tom-got-it/wall-e/images/ota-1.png

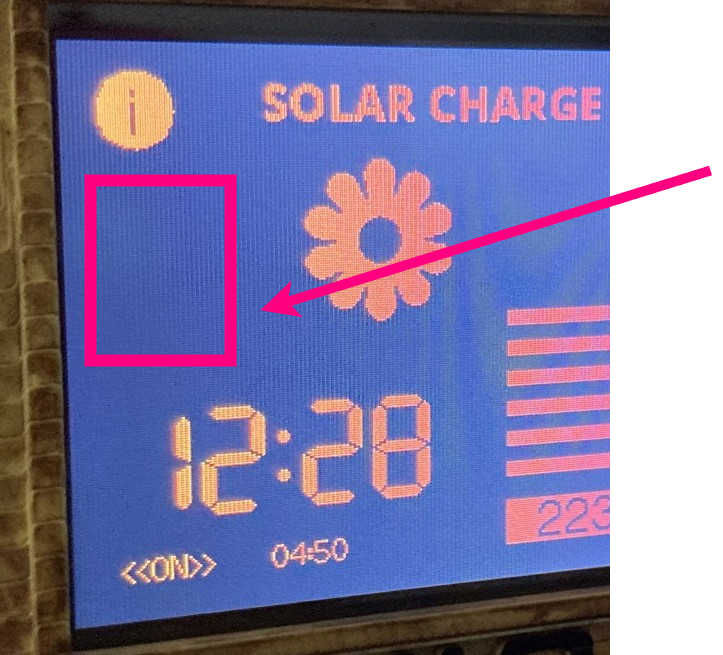
images/ota-1.png
