tom-got-it/wall-e/images/robot-7-front.jpg

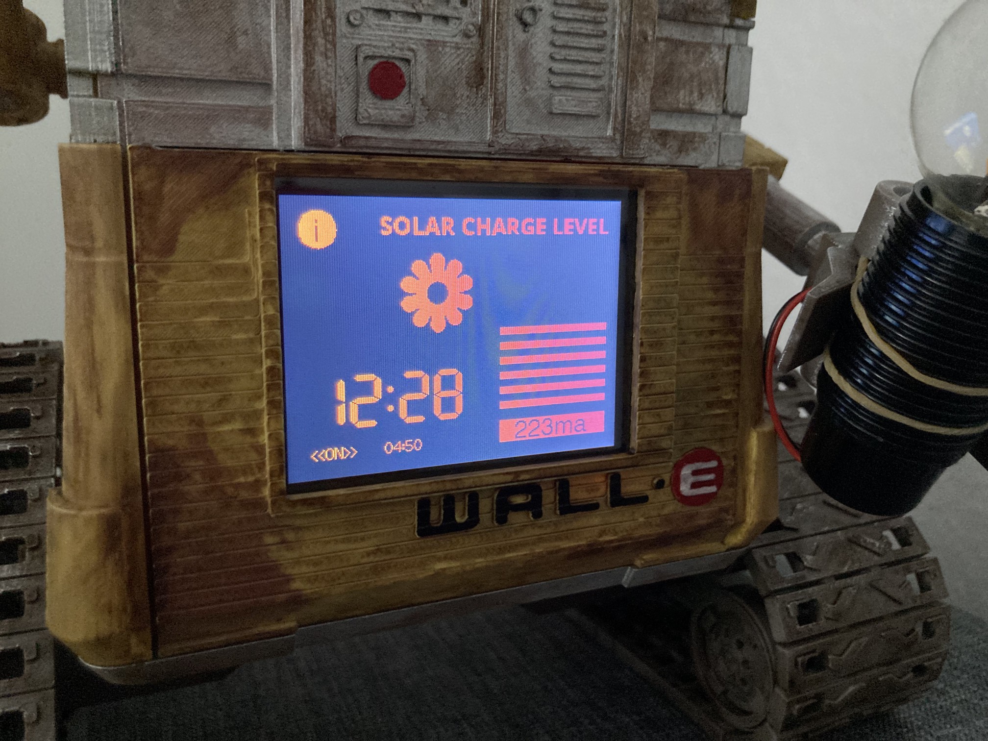
images/robot-7-front.jpg
