tom-got-it/wall-e/(threads)

Thread 1 (2024-08-18):

Flashing light and strange operation of 18650

CarbonVDA, 2024-08-18:
Hello! I have already completely assembled your Wall-E. But, unfortunately, two problems arose. I would really appreciate any help in solving them.
1. The light bulb (5v) starts blinking after a few seconds and the blinking intensifies, and after 30 seconds it turns off.
2. 18650 powers the system, but it’s not at all clear how everything works. The screen always shows 1 division, writes USB and 0.0v or -001.
Thanks in advance for any help.

tom-got-it, 2024-08-18:
Hey CarbonVDA. I hope that I can help - will try my best.

The shutdown after 30 seconds is normal. It is a safety feature to prevent the battery from draining as the light bulb draws a lot of power. The time to auto-shutoff can be configured in file include/global.h.

The blinking however is not normal. I suggest to check the lightbulb and the relay. If possible try to connect the light bulb directly to a 3 to 5v power source directly for testing.

If you power the system by battery and USB power is shown on screen, most certainly there is something wrong with the power sensor (the INA 260 module). The system will try to connect to the INA260 at boot-time. If this fails, it will assume that it is powered by USB. If you built the system without this module it should work nevertheless, but print out USB always. The same module is also used to estimate the charge level of the battery by measuring the battery voltage.

CarbonVDA, 2024-08-19:
Thanks, friend! I connected the light bulb directly from 18650 - there is no flickering. Instead of a light bulb, I connected a voltmeter to the relay, it produces exactly 5 volts. It’s strange why the light from the relay starts flickering after a few seconds. I'll order another INA260, maybe I overheated it when soldering.

Thread 3 (2025-02-23):

Numerous errors. SPIFFS not declared

3dprintandpaint, 2025-02-23:
Hi, I have followed the instructions provided, but cannot progress due to ongoing issues when trying to upload the provided code.

I get a combination of errors as follows:

In file included from C:\Users\monke\AppData\Local\Arduino15\packages\esp32\hardware\esp32\3.1.1\libraries\WebServer\src/HTTP_Method.h:4,
                 from C:\Users\monke\AppData\Local\Arduino15\packages\esp32\hardware\esp32\3.1.1\libraries\WebServer\src/WebServer.h:30,
                 from C:\Users\monke\Documents\Arduino\libraries\ElegantOTA\src/ElegantOTA.h:66,
                 from C:\Users\monke\Downloads\wall-e-main\wall-e-main\src\wall-e\include\global.h:12,
                 from C:\Users\monke\Downloads\wall-e-main\wall-e-main\src\wall-e\wall-e.ino:1:
C:\Users\monke\AppData\Local\Arduino15\packages\esp32\tools\esp32-arduino-libs\idf-release_v5.3-cfea4f7c-v1\esp32/include/http_parser/http_parser.h:95:6: error: 'HTTP_DELETE' conflicts with a previous declaration
   95 |   XX(0,  DELETE,      DELETE)       \
      |      ^
C:\Users\monke\AppData\Local\Arduino15\packages\esp32\tools\esp32-arduino-libs\idf-release_v5.3-cfea4f7c-v1\esp32/include/http_parser/http_parser.h:138:45: note: in definition of macro 'XX'
  138 | #define XX(num, name, string) HTTP_##name = num,
      |                                             ^~~
C:\Users\monke\AppData\Local\Arduino15\packages\esp32\tools\esp32-arduino-libs\idf-release_v5.3-cfea4f7c-v1\esp32/include/http_parser/http_parser.h:139:3: note: in expansion of macro 'HTTP_METHOD_MAP'
  139 |   HTTP_METHOD_MAP(XX)
      |   ^~~~~~~~~~~~~~~
In file included from C:\Users\monke\Downloads\wall-e-main\wall-e-main\src\wall-e\include\global.h:11:
C:\Users\monke\Documents\Arduino\libraries\ESPAsyncWebServer\src/ESPAsyncWebServer.h:64:3: note: previous declaration 'WebRequestMethod HTTP_DELETE'
   64 |   HTTP_DELETE  = 0b00000100,
      |   ^~~~~~~~~~~
C:\Users\monke\AppData\Local\Arduino15\packages\esp32\tools\esp32-arduino-libs\idf-release_v5.3-cfea4f7c-v1\esp32/include/http_parser/http_parser.h:96:6: error: 'HTTP_GET' conflicts with a previous declaration
   96 |   XX(1,  GET,         GET)          \
      |      ^
C:\Users\monke\AppData\Local\Arduino15\packages\esp32\tools\esp32-arduino-libs\idf-release_v5.3-cfea4f7c-v1\esp32/include/http_parser/http_parser.h:138:45: note: in definition of macro 'XX'
  138 | #define XX(num, name, string) HTTP_##name = num,
      |                                             ^~~
C:\Users\monke\AppData\Local\Arduino15\packages\esp32\tools\esp32-arduino-libs\idf-release_v5.3-cfea4f7c-v1\esp32/include/http_parser/http_parser.h:139:3: note: in expansion of macro 'HTTP_METHOD_MAP'
  139 |   HTTP_METHOD_MAP(XX)
      |   ^~~~~~~~~~~~~~~
C:\Users\monke\Documents\Arduino\libraries\ESPAsyncWebServer\src/ESPAsyncWebServer.h:62:3: note: previous declaration 'WebRequestMethod HTTP_GET'
   62 |   HTTP_GET     = 0b00000001,
      |   ^~~~~~~~
C:\Users\monke\AppData\Local\Arduino15\packages\esp32\tools\esp32-arduino-libs\idf-release_v5.3-cfea4f7c-v1\esp32/include/http_parser/http_parser.h:97:6: error: 'HTTP_HEAD' conflicts with a previous declaration
   97 |   XX(2,  HEAD,        HEAD)         \
      |      ^
C:\Users\monke\AppData\Local\Arduino15\packages\esp32\tools\esp32-arduino-libs\idf-release_v5.3-cfea4f7c-v1\esp32/include/http_parser/http_parser.h:138:45: note: in definition of macro 'XX'
  138 | #define XX(num, name, string) HTTP_##name = num,
      |                                             ^~~
C:\Users\monke\AppData\Local\Arduino15\packages\esp32\tools\esp32-arduino-libs\idf-release_v5.3-cfea4f7c-v1\esp32/include/http_parser/http_parser.h:139:3: note: in expansion of macro 'HTTP_METHOD_MAP'
  139 |   HTTP_METHOD_MAP(XX)
      |   ^~~~~~~~~~~~~~~
C:\Users\monke\Documents\Arduino\libraries\ESPAsyncWebServer\src/ESPAsyncWebServer.h:67:3: note: previous declaration 'WebRequestMethod HTTP_HEAD'
   67 |   HTTP_HEAD    = 0b00100000,
      |   ^~~~~~~~~
C:\Users\monke\AppData\Local\Arduino15\packages\esp32\tools\esp32-arduino-libs\idf-release_v5.3-cfea4f7c-v1\esp32/include/http_parser/http_parser.h:98:6: error: 'HTTP_POST' conflicts with a previous declaration
   98 |   XX(3,  POST,        POST)         \
      |      ^
C:\Users\monke\AppData\Local\Arduino15\packages\esp32\tools\esp32-arduino-libs\idf-release_v5.3-cfea4f7c-v1\esp32/include/http_parser/http_parser.h:138:45: note: in definition of macro 'XX'
  138 | #define XX(num, name, string) HTTP_##name = num,
      |                                             ^~~
C:\Users\monke\AppData\Local\Arduino15\packages\esp32\tools\esp32-arduino-libs\idf-release_v5.3-cfea4f7c-v1\esp32/include/http_parser/http_parser.h:139:3: note: in expansion of macro 'HTTP_METHOD_MAP'
  139 |   HTTP_METHOD_MAP(XX)
      |   ^~~~~~~~~~~~~~~
C:\Users\monke\Documents\Arduino\libraries\ESPAsyncWebServer\src/ESPAsyncWebServer.h:63:3: note: previous declaration 'WebRequestMethod HTTP_POST'
   63 |   HTTP_POST    = 0b00000010,
      |   ^~~~~~~~~
C:\Users\monke\AppData\Local\Arduino15\packages\esp32\tools\esp32-arduino-libs\idf-release_v5.3-cfea4f7c-v1\esp32/include/http_parser/http_parser.h:99:6: error: 'HTTP_PUT' conflicts with a previous declaration
   99 |   XX(4,  PUT,         PUT)          \
      |      ^
C:\Users\monke\AppData\Local\Arduino15\packages\esp32\tools\esp32-arduino-libs\idf-release_v5.3-cfea4f7c-v1\esp32/include/http_parser/http_parser.h:138:45: note: in definition of macro 'XX'
  138 | #define XX(num, name, string) HTTP_##name = num,
      |                                             ^~~
C:\Users\monke\AppData\Local\Arduino15\packages\esp32\tools\esp32-arduino-libs\idf-release_v5.3-cfea4f7c-v1\esp32/include/http_parser/http_parser.h:139:3: note: in expansion of macro 'HTTP_METHOD_MAP'
  139 |   HTTP_METHOD_MAP(XX)
      |   ^~~~~~~~~~~~~~~
C:\Users\monke\Documents\Arduino\libraries\ESPAsyncWebServer\src/ESPAsyncWebServer.h:65:3: note: previous declaration 'WebRequestMethod HTTP_PUT'
   65 |   HTTP_PUT     = 0b00001000,
      |   ^~~~~~~~
C:\Users\monke\AppData\Local\Arduino15\packages\esp32\tools\esp32-arduino-libs\idf-release_v5.3-cfea4f7c-v1\esp32/include/http_parser/http_parser.h:102:6: error: 'HTTP_OPTIONS' conflicts with a previous declaration
  102 |   XX(6,  OPTIONS,     OPTIONS)      \
      |      ^
C:\Users\monke\AppData\Local\Arduino15\packages\esp32\tools\esp32-arduino-libs\idf-release_v5.3-cfea4f7c-v1\esp32/include/http_parser/http_parser.h:138:45: note: in definition of macro 'XX'
  138 | #define XX(num, name, string) HTTP_##name = num,
      |                                             ^~~
C:\Users\monke\AppData\Local\Arduino15\packages\esp32\tools\esp32-arduino-libs\idf-release_v5.3-cfea4f7c-v1\esp32/include/http_parser/http_parser.h:139:3: note: in expansion of macro 'HTTP_METHOD_MAP'
  139 |   HTTP_METHOD_MAP(XX)
      |   ^~~~~~~~~~~~~~~
C:\Users\monke\Documents\Arduino\libraries\ESPAsyncWebServer\src/ESPAsyncWebServer.h:68:3: note: previous declaration 'WebRequestMethod HTTP_OPTIONS'
   68 |   HTTP_OPTIONS = 0b01000000,
      |   ^~~~~~~~~~~~
C:\Users\monke\AppData\Local\Arduino15\packages\esp32\tools\esp32-arduino-libs\idf-release_v5.3-cfea4f7c-v1\esp32/include/http_parser/http_parser.h:128:6: error: 'HTTP_PATCH' conflicts with a previous declaration
  128 |   XX(28, PATCH,       PATCH)        \
      |      ^~
C:\Users\monke\AppData\Local\Arduino15\packages\esp32\tools\esp32-arduino-libs\idf-release_v5.3-cfea4f7c-v1\esp32/include/http_parser/http_parser.h:138:45: note: in definition of macro 'XX'
  138 | #define XX(num, name, string) HTTP_##name = num,
      |                                             ^~~
C:\Users\monke\AppData\Local\Arduino15\packages\esp32\tools\esp32-arduino-libs\idf-release_v5.3-cfea4f7c-v1\esp32/include/http_parser/http_parser.h:139:3: note: in expansion of macro 'HTTP_METHOD_MAP'
  139 |   HTTP_METHOD_MAP(XX)
      |   ^~~~~~~~~~~~~~~
C:\Users\monke\Documents\Arduino\libraries\ESPAsyncWebServer\src/ESPAsyncWebServer.h:66:3: note: previous declaration 'WebRequestMethod HTTP_PATCH'
   66 |   HTTP_PATCH   = 0b00010000,
      |   ^~~~~~~~~~
C:\Users\monke\Downloads\wall-e-main\wall-e-main\src\wall-e\setup.ino: In function 'void setupFilesystem()':
C:\Users\monke\Downloads\wall-e-main\wall-e-main\src\wall-e\setup.ino:78:8: error: 'SPIFFS' was not declared in this scope; did you mean 'U_SPIFFS'?
   78 |   if (!SPIFFS.begin()) {
      |        ^~~~~~
      |        U_SPIFFS
C:\Users\monke\Downloads\wall-e-main\wall-e-main\src\wall-e\setup.ino: In function 'void setupCalibrateTFT()':
C:\Users\monke\Downloads\wall-e-main\wall-e-main\src\wall-e\setup.ino:90:7: error: 'SPIFFS' was not declared in this scope; did you mean 'U_SPIFFS'?
   90 |   if (SPIFFS.exists(CALIBRATION_FILE)) {
      |       ^~~~~~
      |       U_SPIFFS
C:\Users\monke\Downloads\wall-e-main\wall-e-main\src\wall-e\setup.ino:133:14: error: 'SPIFFS' was not declared in this scope; did you mean 'U_SPIFFS'?
  133 |     File f = SPIFFS.open(CALIBRATION_FILE, "w");
      |              ^~~~~~
      |              U_SPIFFS
C:\Users\monke\Downloads\wall-e-main\wall-e-main\src\wall-e\setup.ino: In function 'void prepareWebServer()':
C:\Users\monke\Downloads\wall-e-main\wall-e-main\src\wall-e\setup.ino:249:20: error: cannot convert 'AsyncWebServer*' to 'WebServer*'
  249 |   ElegantOTA.begin(&server);
      |                    ^~~~~~~
      |                    |
      |                    AsyncWebServer*
C:\Users\monke\Documents\Arduino\libraries\ElegantOTA\src/ElegantOTA.h:82:38: note:   initializing argument 1 of 'void ElegantOTAClass::begin(WebServer*, const char*, const char*)'
   82 |     void begin(ELEGANTOTA_WEBSERVER *server, const char * username = "", const char * password = "");
      |                                      ^
C:\Users\monke\Downloads\wall-e-main\wall-e-main\src\wall-e\setup.ino:250:14: error: 'class ElegantOTAClass' has no member named 'setAutoReboot'
  250 |   ElegantOTA.setAutoReboot(false);
      |              ^~~~~~~~~~~~~

exit status 1

Compilation error: 'SPIFFS' was not declared in this scope; did you mean 'U_SPIFFS'?
