tom-got-it/wall-e/(commit log)

2024-06-22 added links to printables
2024-06-23 MP3-Player, Main-Menu, English Translations, Bug-Fixes
    [alarm-srceen.ino, alarm.ino, battery.ino, global.h, light-bulb.ino, main-screen.ino, menu-screen.ino, mp3-player.ino]
2024-06-25 Store onto RTC backed up by battery wether alarm is enabled.
2024-06-29 timer + fixes
2024-06-29 Fixed bug - mp3 not stopping playback when exiting alarm
    [alarm-srceen.ino]
2025-12-18 Clarify battery charger version compatibility
    Added a note about the Amazon version of the battery charger.
